DesignSparkRS/rpi-industrial-psu/simulation/Maxim_PWM_MAX17576.pdf

## Initial Design

1.0

### Design Requirements

Parameter | Value
Minimum Input Voltage | 9V
Maximum Input Voltage | 30V
Nominal Input Voltage | 12V
Input Steady-State Ripple | 2%
Input Undervoltage Lockout Level | 5.85V
Output Voltage | 5.1V
Output Current | 2.5A
Output Voltage Load Step Over/Undershoot | 2%
Load Start Current | 0.5A
Load Pulse Current | 1.5A
Load Pulse Edge Rate | 10A/us
Performance Priority | Balance Efficiency and Size
BOM Priority | Low Cost
Mode of Operation | PWM
Switching Frequency | 1113kHz
Soft Start Time | 5ms
Ambient Temperature | 25°C

# EE-Sim

## DC-DC

© 2020 Maxim Integrated. All rights reserved. | Page 1 of 24

### Schematic

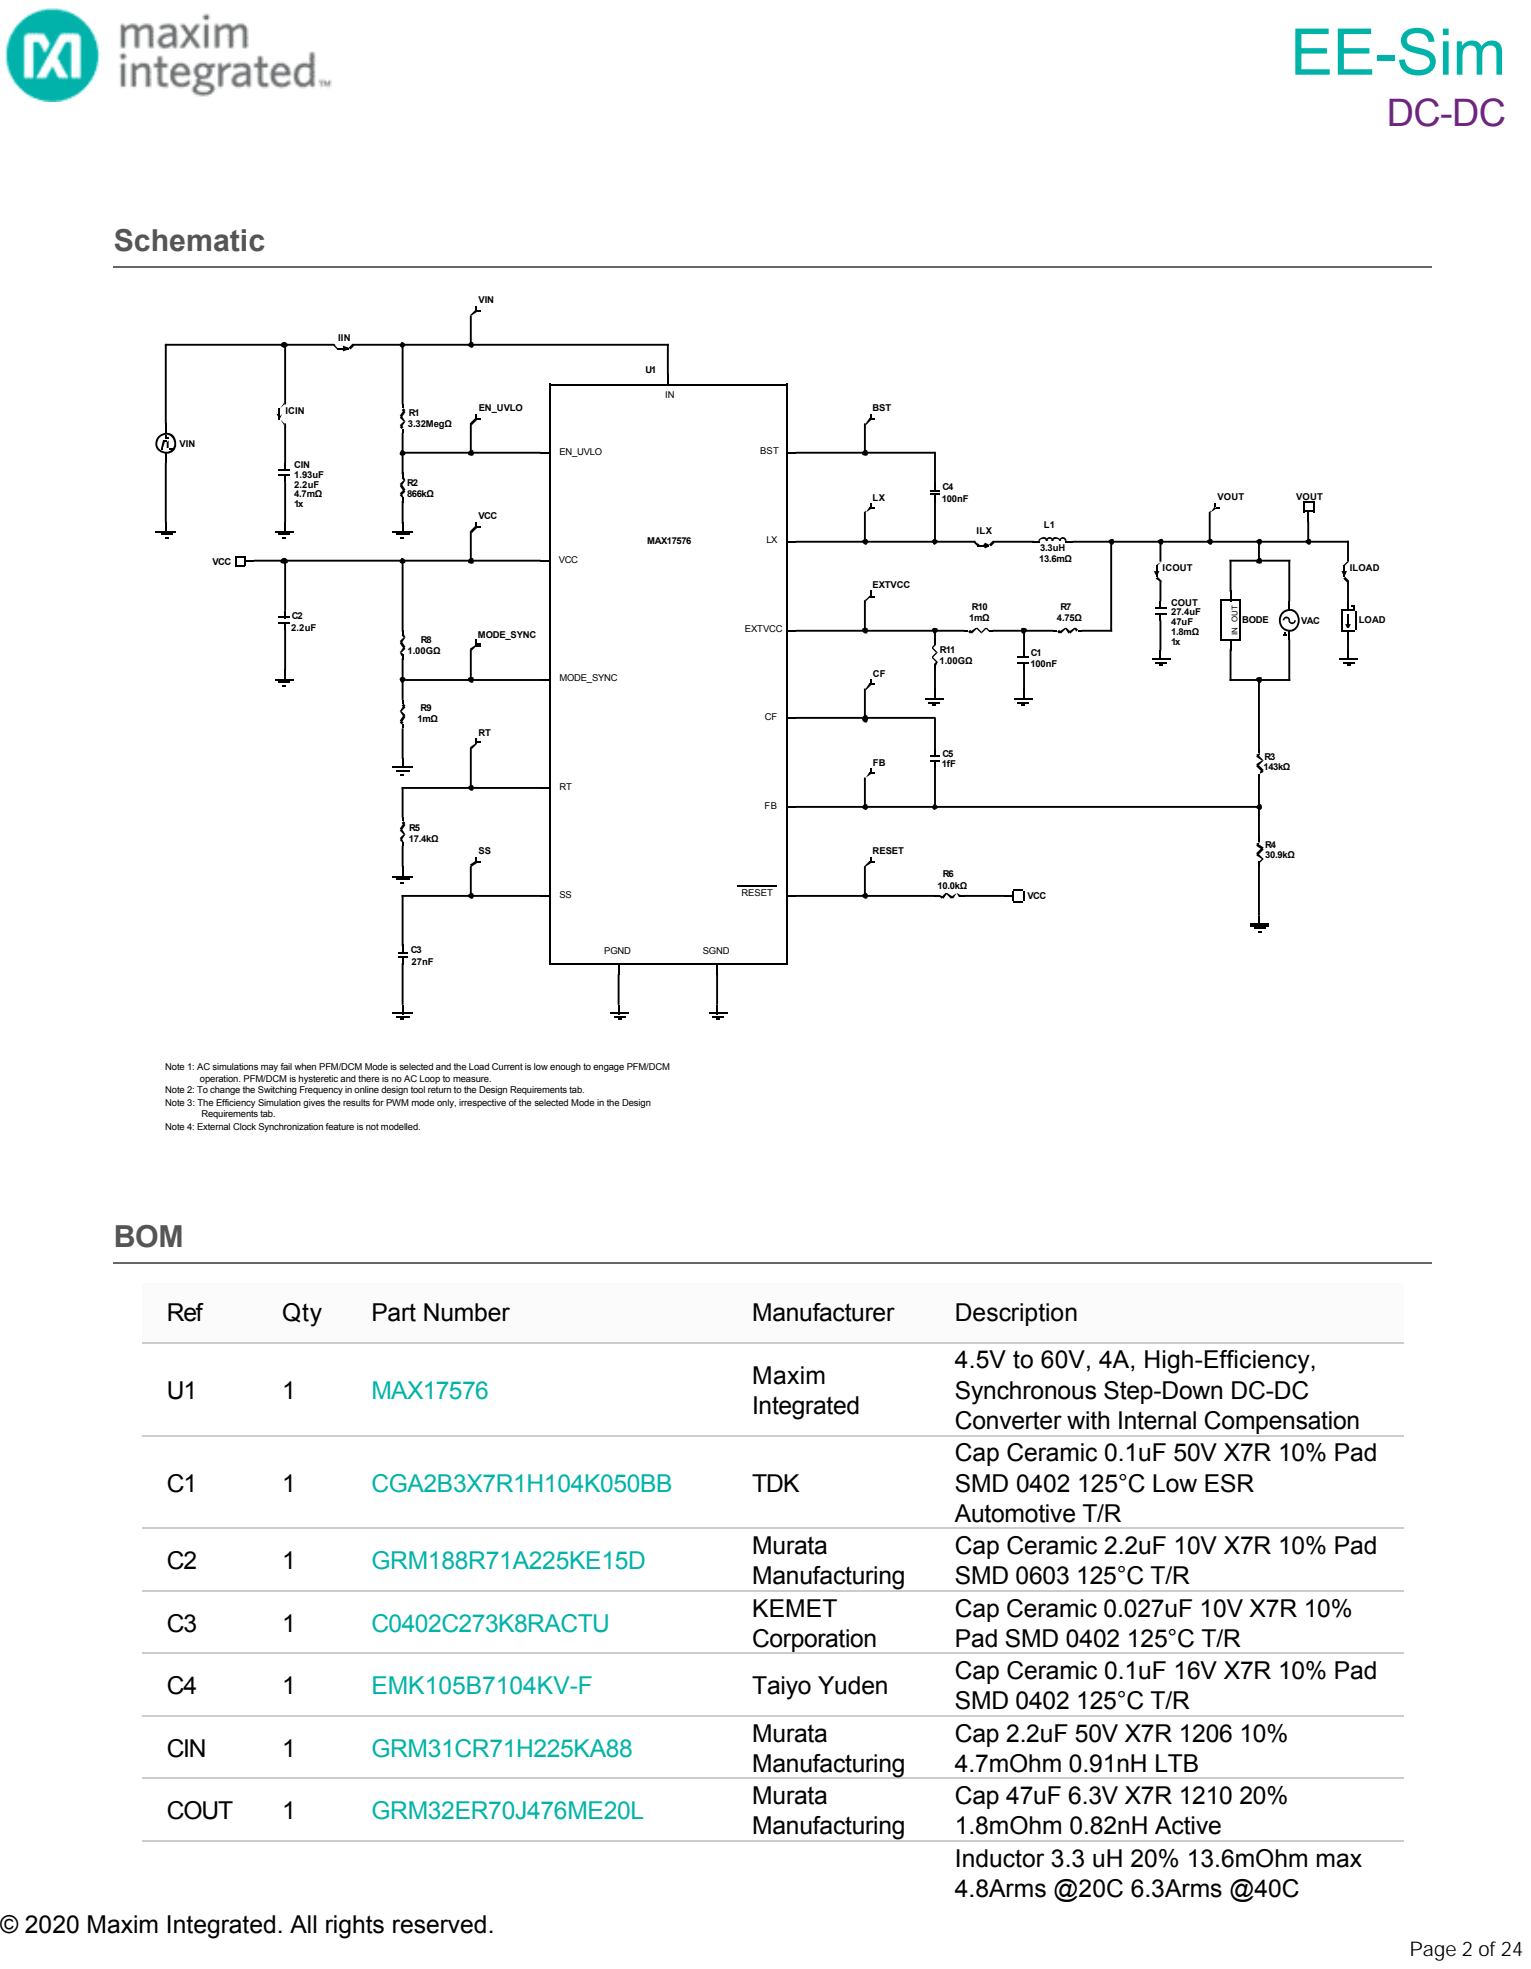
[picture p2: page 2]

Note 1: AC simulations may fail when PFM/DCM Mode is selected and the Load Current is low enough to engage PFM/DCM

operation. PFM/DCM is hysteretic and there is no AC Loop to measure.

Note 2: To change the Switching Frequency in online design tool return to the Design Requirements tab.
Note 3: The Efficiency Simulation gives the results for PWM mode only, irrespective of the selected Mode in the Design

Note 4: External Clock Synchronization feature is not modelled.

4.5V to 60V, 4A, High-Efficiency,
Synchronous Step-Down DC-DC
Converter with Internal Compensation
Cap Ceramic 0.1uF 50V X7R 10% Pad
SMD 0402 125°C Low ESR
Automotive T/R
Cap Ceramic 2.2uF 10V X7R 10% Pad
SMD 0603 125°C T/R
Cap Ceramic 0.027uF 10V X7R 10%
Pad SMD 0402 125°C T/R

L1 | 1 | MSS1246-332MLB (https://maxim.transim.com/pwm2/txd/Transim.VPS.txd?f=link&disti=3&l=none&uic=en-US&pn=50000741) | Coilcraft | 10.16Asat @-10% 11.24Asat @-20% 11.76Asat @-30% 4.8mmHt 151.29mm^2 MSS1246 Active
R1 | 1 | CRCW04023M32FKED (https://maxim.transim.com/pwm2/txd/Transim.VPS.txd?f=link&disti=3&l=none&uic=en-US&pn=se_25141388) | Vishay | Res Thick Film 0402 3.32M Ohm 1% 0.063W(1/16W) ±100ppm/°C Pad SMD Automotive T/R
R2 | 1 | ERJ2RKF8663X (https://maxim.transim.com/pwm2/txd/Transim.VPS.txd?f=link&disti=3&l=none&uic=en-US&pn=se_25455457) | Panasonic | Res Thick Film 0402 866K Ohm 1% 0.1W(1/10W) ±100ppm/°C Pad SMD Automotive T/R
R3 | 1 | CRG0402-P-1433FT (https://maxim.transim.com/pwm2/txd/Transim.VPS.txd?f=link&disti=3&l=none&uic=en-US&pn=se_80706339) | Venkel | Res Thick Film 0402 143K Ohm 1% 0.063W(1/16W) ±100ppm/°C Pad SMD T/R
R4 | 1 | CRG0402-P-3092FT (https://maxim.transim.com/pwm2/txd/Transim.VPS.txd?f=link&disti=3&l=none&uic=en-US&pn=se_80708815) | Venkel | Res Thick Film 0402 30.9K Ohm 1% 0.063W(1/16W) ±100ppm/°C Pad SMD T/R
R5 | 1 | NTR04F1742DTRF (https://maxim.transim.com/pwm2/txd/Transim.VPS.txd?f=link&disti=3&l=none&uic=en-US&pn=se_34749768) | NIC Components | Res Thin Film 0402 17.4K Ohm 1% 0.063W(1/16W) ±50ppm/°C Pad SMD T/R
R6 | 1 | RCG040210K0FKED (https://maxim.transim.com/pwm2/txd/Transim.VPS.txd?f=link&disti=3&l=none&uic=en-US&pn=se_51675126) | Vishay | Res Thick Film 0402 10K Ohm 1% 0.063W(1/16W) ±100ppm/°C Pad SMD T/R
R7 | 1 | CRG0402-P-4R75FT (https://maxim.transim.com/pwm2/txd/Transim.VPS.txd?f=link&disti=3&l=none&uic=en-US&pn=se_80707303) | Venkel | Res Thick Film 0402 4.75 Ohm 1% 0.063W(1/16W) -300ppm/°C to 500ppm/°C Pad SMD T/R

### Simulation Results

AC Analysis Fri Nov 27 2020 10:10:54

BODE | Default

Phase Margin: 62.15° at a crossover frequency of 60.6kHz ▼
20 30 40 | 50 60 70 80 | 90 100 110

Efficiency Fri Nov 27 2020 10:10:54

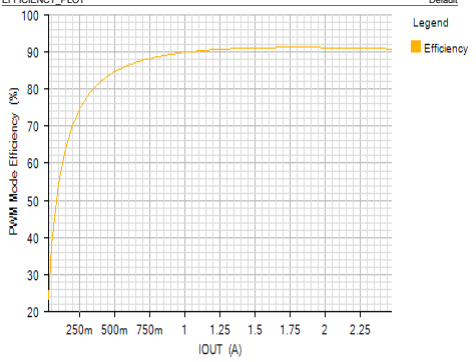
[picture p3: figure]

EFFICIENCY_PLOT | Default

POWER_LOSS_PLOT | Default

JUNCTION_TEMPERATURE_PLOT | Default

Losses

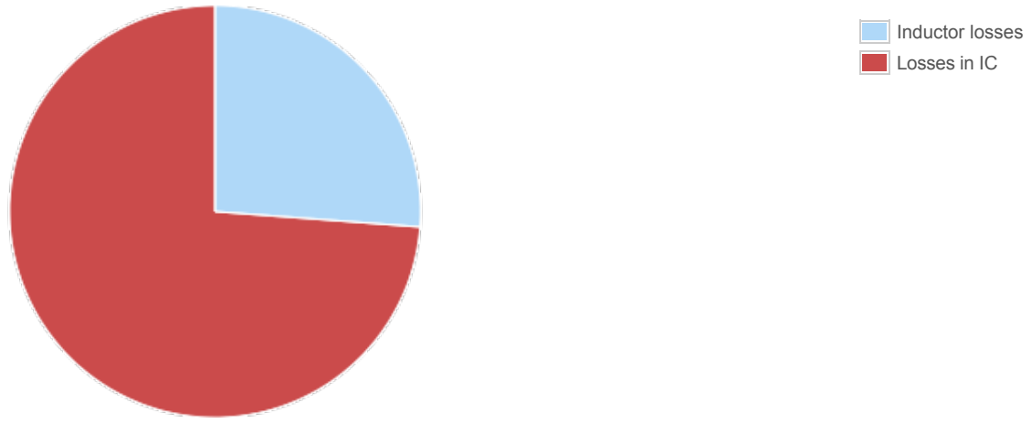
[picture p4: figure]
Inductor losses; Losses in IC

Component | Loss (W) | % of total

Component | Loss (W) | % of total
| Inductor losses | 0.33 | 26.2
| Losses in IC | 0.93 | 73.8
| Total | 1.26 | 100

Steady State Fri Nov 27 2020 10:10:54

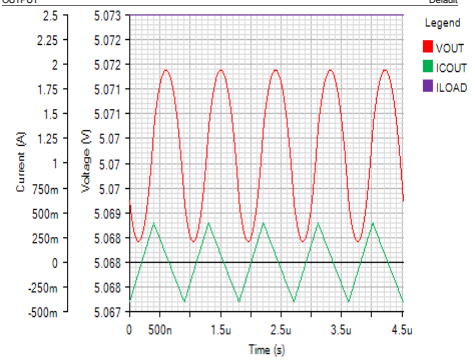
[picture p5: figure]

OUTPUT | Default

IC | Default

INPUT | Default

SWITCHING | Default

Line Transient Fri Nov 27 2020 10:10:54

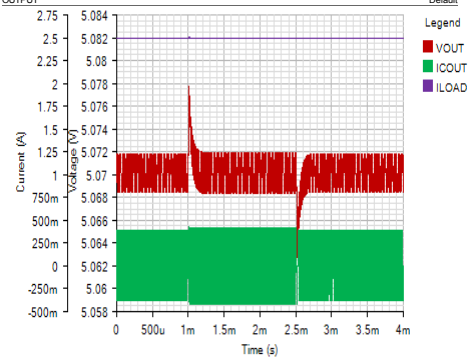
[picture p6: figure]

OUTPUT | Default

IC | Default

INPUT | Default

SWITCHING | Default

Load Step Fri Nov 27 2020 10:10:54

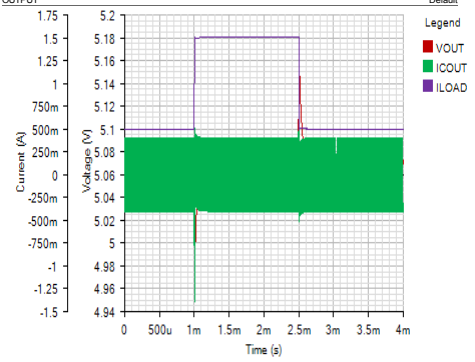
[picture p7: figure]

OUTPUT | Default

IC | Default

INPUT | Default

SWITCHING | Default

Start Up Fri Nov 27 2020 10:10:54

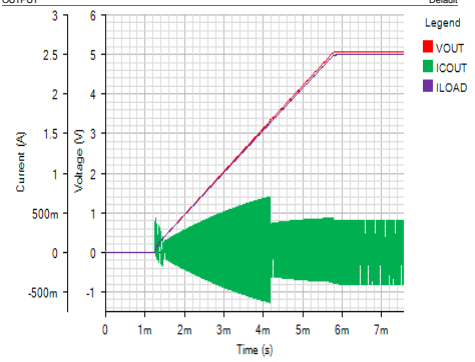
[picture p8: figure]

OUTPUT | Default

IC | Default

INPUT | Default

SWITCHING | Default
