DesignSparkRS/rpi-industrial-psu/(list of files, drawings)

Other design files:
design/RPi PSU.pcb
