DesignSparkRS/rpi-industrial-psu/(commit log)

2021-01-26 Update README and add files
    Updated README to include project description. Added project simulation, design and output files.
    [RPi PSU (rsbom).csv, RPi PSU.pcb, RPi PSU.sch]
2021-01-26 Update README and add files
    Update README
    Actually include README text
    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
    [RPi PSU (rsbom).csv, RPi PSU.pcb, RPi PSU.sch]
